JimCom123/Si4735_ESP32_Radio/SI4735-Radio-ESP32-Touchscreen-Arduino3/Sch_Brd/Photo Rev1.0/IMG_1637.jpg

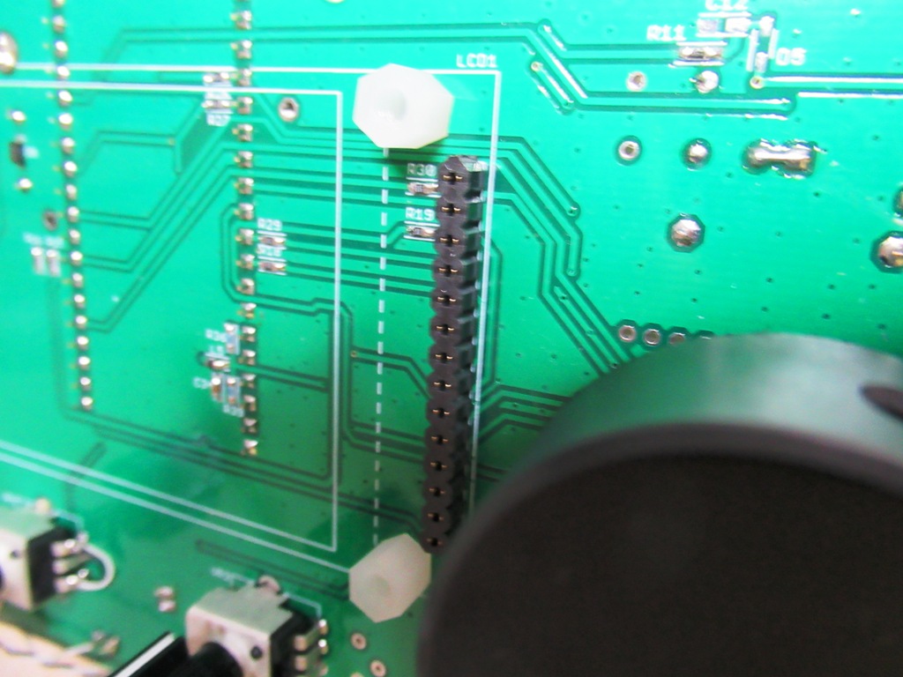
SI4735-Radio-ESP32-Touchscreen-Arduino3/Sch_Brd/Photo Rev1.0/IMG_1637.jpg
