JimCom123/Si4735_ESP32_Radio/README.md

# Si4735_ESP32_Radio
Based on SI4735-Radio-ESP32-2.8 inch TFT Touchscreen-Arduino and improved.
