JimCom123/Si4735_ESP32_Radio/SI4735-Radio-ESP32-Touchscreen-Arduino3/Sch_Brd/Si4735D60GU32_H6_BOM.xls

Value | Value | Qty | Part Num |  | Package | Parts
4.0uH | T37-6 37t | 1 | Amidon | 秋月電子 | T37 | L1 |  | T37-2 32t | T50-2 29t
BK1608HM601 | BK1608HM601 | 1 | Taiyo Yuden | Mouser | L0603 | L5
4.7uH | L0603B4R7MDWFT | 2 | KEMET | Mouser | L0603 | L6, L7
100nH | MLF2012DR10JT000 | 1 | TDK | Mouser | L0805 | L2 | MLF2012DR10JT000
220uH | AL0510-221K | 1 | Core Master | 秋月電子 | AL0510 | L3
2.2mH | AL0510-222K | 1 | Core Master | 秋月電子 | AL0510 | L4
2pF | 未実装 |  |  |  | C0402 | (C9)
10pF/50V | 未実装 |  |  |  | C0603 | (C23, C26, C32, C39, C40, C44, C45)
47pF/25V | C0603C470K3GACTU | 3 | KEMET | Mouser | C0603 | C6, C8, C10
220pF/50V | C0603C221K5GACAUTO |  | KEMET | Mouser | C0603 | (C12)
1000pF/50V | C0603C102K5GACAUTO | 1 | KEMET | Mouser | C0603 | C11
0.022uF/25V | GCJ188R71E223KA01D | 2 | Murata | Mouser | C0603 | C19, C29
0.1uF | GRM188R71H104KA93D | 12 | Murata | Mouser | C0603 | C3, C4, C7, C13, C14, C17, C22, C27, C28, C33, C34, C49
0.01uF | GRM188R71H103KA93D | 4 | Murata | Mouser | C0603 | C2, C46 +C4, +C7
0.47uF/25V | TMK107B7474KA | 3 | Taiyo Yuden | Mouser | C0603 | C1, C5, C15
1uF/25V | TMK107B7105KA-T | 5 | Taiyo Yuden | Mouser | C0603 | C21, C30, C35, C51, C53
2.2uF/16V | EMK107BJ225KA-T | 1 | Taiyo Yuden | Mouser | C0603 | C48
10uF/25V | GRM188R61E106KA73D | 3 | Murata | Mouser | C0603 | C16, C18, C25, (C31), (C38), (C43), (C52)
0.01uF/100V Film | 100MU103MA13216 | 1 | Rubycon | 秋月電子 | C1206 | C47
1uF/25V Film | 25MU105MA23216 | 1 | Rubycon | 秋月電子 | C1206 | C50
10uF/16V Film | 16MU106MC44532 | 2 | Rubycon | 秋月電子 | C4632 | C20, C24
0.022uF Film | MKS0C022200B00JSSD | 2 | WIMA | Mouser | C035-055X025 | C36, C37
0.0047uF Film | MKS02-4700/250/10 | 2 | WIMA | Mouser | C035-055X025 | C41, C42
47uF/25V | UKA1E470MDD | 1 | Nichicon | Mouser | CE-020X050 | C54 | 33uF/16V OS
NIL | 未実装 | 3 |  |  | R0603 | R28, R42, R43
0 | 0 | 1 | * | Mouser | R0603 | JP1
4.7 | 4.7 | 1 | * | Mouser | R0603 | R35
10 | 10 | 2 | * | Mouser | R0603 | R5, R23
22 | 22 | 1 | * | Mouser | R0603 | R22
51 | 51 | 10 | * | Mouser | R0603 | R2, R17, R18, R19, R26, R27, R29, R30, R44, R45
100 | 100 | 2 | * | Mouser | R0603 | R33, R34
390 | 390 | 2 | * | Mouser | R0603 | R37, R38
470 | 470 | 5 | * | Mouser | R0603 | R11, R12, R13, R40, R41
1.8k | 1.8k | 2 | * | Mouser | R0603 | R36, R39
4.7k | 4.7k | 4 | * | Mouser | R0603 | R14, R20, R24, R25
10k | 10k | 2 | * | Mouser | R0603 | R31, R32
15k | 15k | 2 | * | Mouser | R0603 | R15, R16
22k | 22k | 1 | * | Mouser | R0603 | R4
100k | 100k | 1 | * | Mouser | R0603 | R1
22 | 未実装 |  |  |  | R0402 | (R6, R7, R8)
560 | 未実装 |  |  |  | R0402 | (R9)
2k | 未実装 |  |  |  | R0402 | (R10)
4.7 1/2W | 4.7 1/2W | 1 | * | Mouser | R1206 | R21
FT37-77 12t | FT37-77 12t | 1 | * | Mouser | R1210 | R3
PTV09A-4025F-B103 | PTV09A-4025F-B103 | 1 | Bourns | Mouser |  | VR1
PTV09A-4025F-A103 | PTV09A-4025F-A103 | 1 | Bourns | Mouser |  | VR2
 | 未実装 | 1 | * |  | GF063P1 | TM1
NFM21PS106B0J3D | NFM21PS106B0J3D | 6 | Murata | Mouser | NFM21P | FIL1, FIL2, FIL3, FIL4, FIL5, FIL7
BNX016-01 | BNX016-01 | 1 | Murata | 秋月電子 | BNX0 | FIL6
SI4735-GU | SI4735-GU | 1 | SiLabs |  | SSOP24 | IC1
NJM2863F33 | NJM2863F33 | 1 | JRC | 秋月電子 | SOT23-5L | IC2
HT82V739SO | HT82V739SO | 1 | HOLTEK | 秋月電子 | SO08 | IC3
2SC3265Y | 2SC3265Y | 1 | Toshiba | 秋月電子 | SC59 | TR1
2SA1298Y | 2SA1298Y | 1 | Toshiba | 秋月電子 | SC59 | TR2
2SC2412KT146Q | 2SC2412KT146Q | 2 | Rohm | 秋月電子 | SC59 | TR3, TR4
2SK882GR | 2SK882GR (2SK241GR) | 1 | Toshiba |  | SC70 | FET1 | 2SK241GR
IRLML6402 | IRLML6402 | 1 | IR |  | SC70 | FET2
1N4148W | 1N4148W | 3 | Diodes | 秋月電子 | SOD2713X115N | (D5), D6, D7, D8
BAT43XV2 | BAT43XV2 | 4 | Fairchild | 秋月電子 | SODFL1608X70N | D1, D2, D3, D4
ECS-327TXO-33 | ECS-327TXO-33 | 1 | ECS | Mouser | XOSC | X1
M028C9341SD | M028C9341SD | 1 | HiLetgo | Amazon | M028C9341SD | LCD1
ESP32-DEVKITC v4 | ESP32-DevKitC-32D v4 | 1 | Espressif | 秋月電子 | ESP32-DEVKITC | U1
ADP3338AKCZ-3.3 | ADP3338AKCZ-3.3 | 1 | Analog | 秋月電子 |  | U1
PEC11R-4020F-S0024 | PEC11R-4020F-S0024 | 1 | Bourns | Mouser | PEC11R4220FS0024 | ENC1
SPPJ222200 | SPPJ222200 | 1 | ALPS | Mouser | SPPJ2 | SW1
UE200012 | UE200012 | 1 | ALPS | Mouser | SPPJ2 | SW1
S-037-TGG | S-037-TGG | 2 | COSMTEC | 秋月電子 | BU-SMA-V | CN1, CN2
B8B-PH-K-S | 未実装 | 1 | JST | Mouser | B8B-PH-K | (CN3)
B2B-XH2 | B2B-XH2 | 1 | JST | 秋月電子 | XH2 | CN4
MJ-179PH | MJ-179PH | 1 | マル信 | 秋月電子 | MJ179P | J1
MJ-354W-SG | MJ-354W-SG | 1 | マル信 | 秋月電子 | MJ-354W-SG | CN5
UDB-05LFPN | UDB-05LFPN | 1 | DB Products | 秋月電子 | 12mm | BZ1
スピーカー | SC400408-1 | 1 | DB Unlimited | Mouser | SPKR | SP1
KNOB | 11K5013-KMNB | 1 | Grayhill | Mouser | 33.78mm | ENC1
KNOB | 11K5014-KCNB | 2 | Grayhill | Mouser | 117.78mm | VR1, VR2
ピンソケット | FHU-1x42SG | 2 | Useconn | 秋月電子 |  | U1
ピンソケット | 2212S-04SG-36 | 1 | Neltron | 秋月電子 |  | LCD1 |  | LCDに実装されたピンヘッダーは取り外しロープロファイルタイプに交換
ピンソケット | 2212S-14SG-36 | 1 | Neltron | 秋月電子 |  | LCD1
ピンヘッダー | 2211S-14G-774 | 1 | Neltron | 秋月電子 |  | LCD1
ピンヘッダー | 2211S-40G-774 | 1 | Neltron | 秋月電子 |  | LCD1
ケース | SS-160B | 1 | タカチ | 共立電子
M3X12mmスペーサー | TPS-M3-12 | 6 | タカチ | 共立電子 |  | タッピング 基板用
M3x2.5mmスペーサー |  | 6 |  | 共立電子 |  | 中空 基板用
M3x6mmスペーサー | TPS632-6 | 4 |  | 秋月電子 |  | おねじめねじ LCD用
