JimCom123/Si4735_ESP32_Radio/(list of files, cad)

Other CAD files:
SI4735-Radio-ESP32-Touchscreen-Arduino3/Enclosure/SS-160B_20191216133921.dwg
