JimCom123/Si4735_ESP32_Radio/SI4735-Radio-ESP32-Touchscreen-Arduino3/Enclosure/Dim.pdf

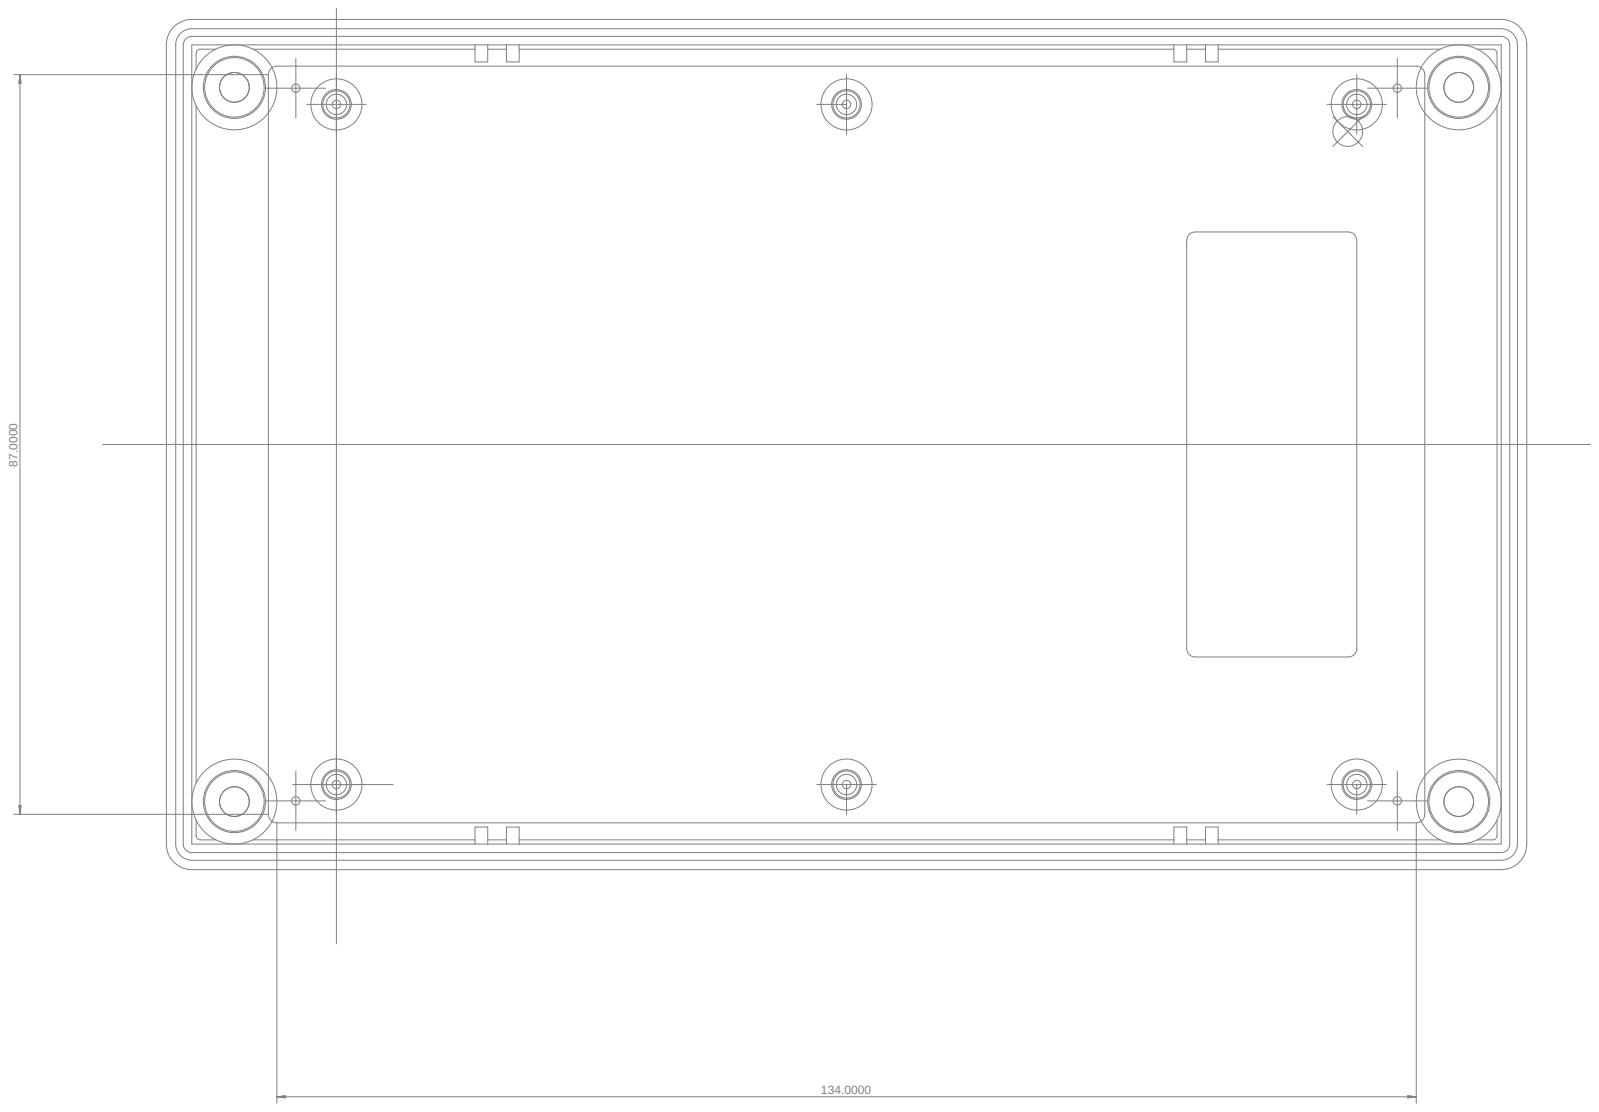
[picture p15: page 1]
