JimCom123/Si4735_ESP32_Radio/SI4735-Radio-ESP32-Touchscreen-Arduino3/Enclosure/DimS.pdf

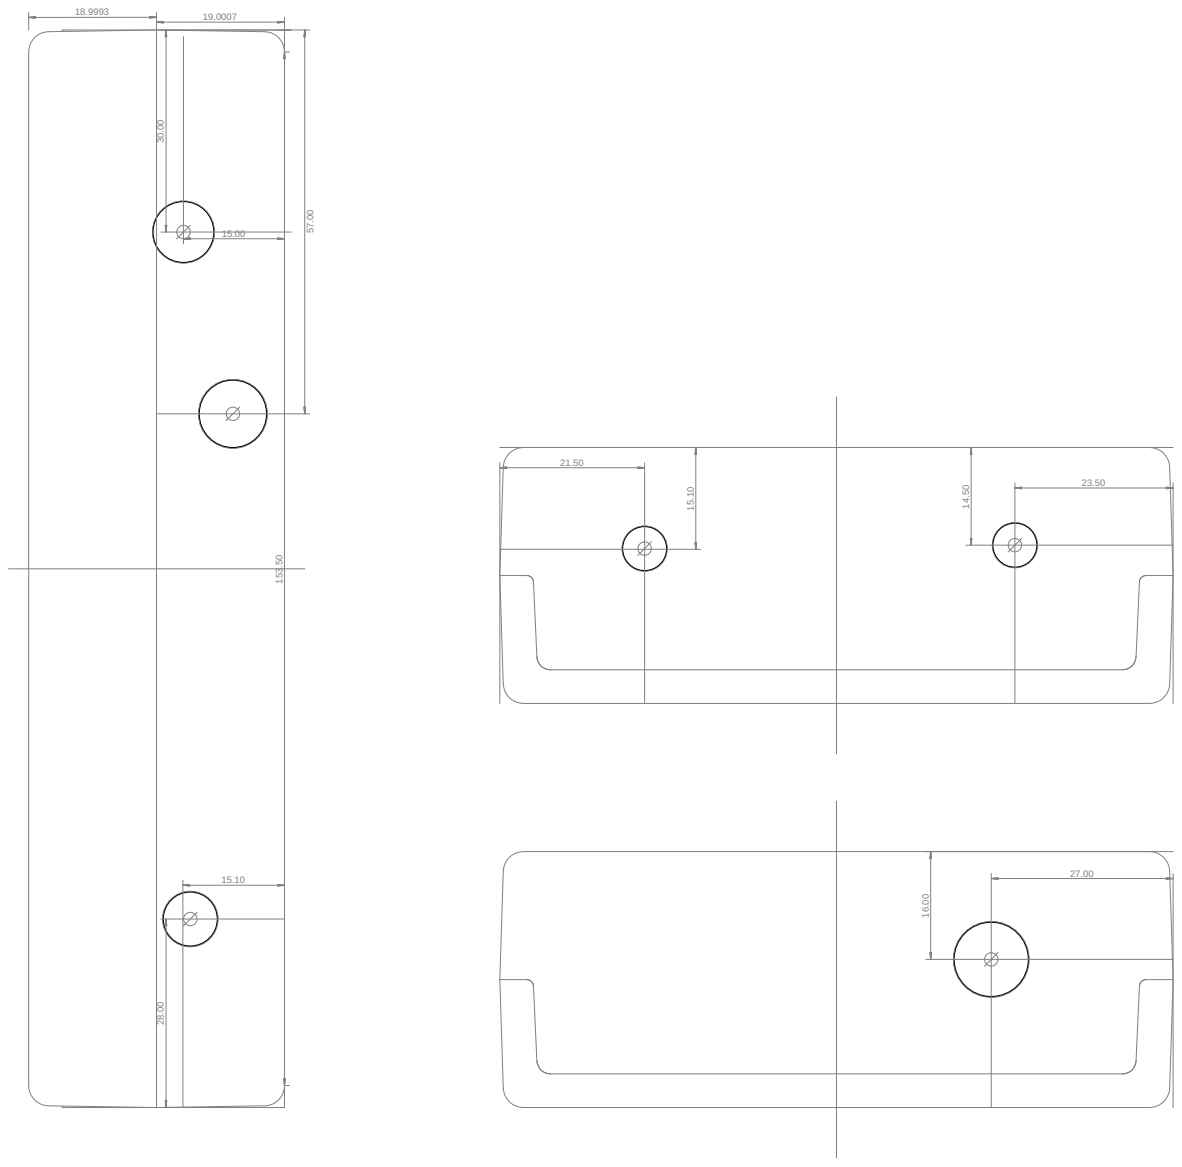
[picture p16: page 1]
