JimCom123/Si4735_ESP32_Radio/SI4735-Radio-ESP32-Touchscreen-Arduino3/Enclosure/Si4735D60GU32_H_6FNT.pdf

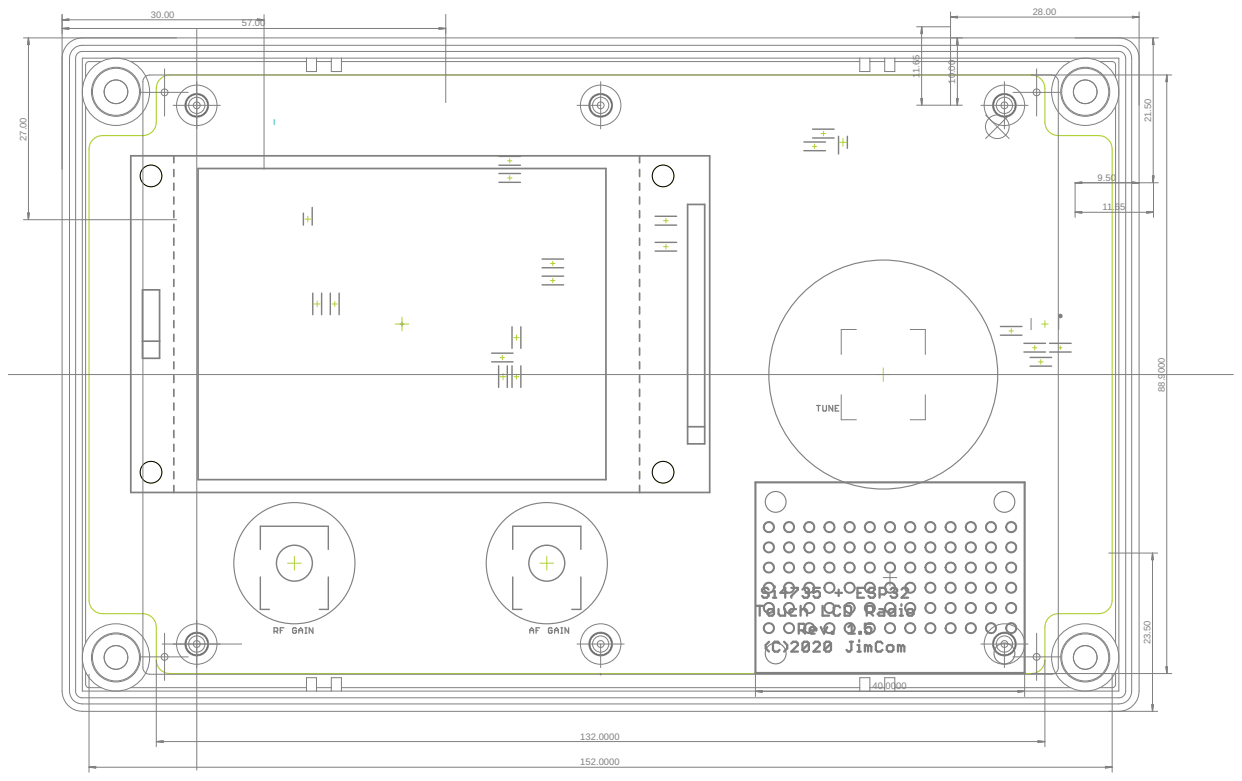
[picture p17: page 1]
