JimCom123/Si4735_ESP32_Radio/SI4735-Radio-ESP32-Touchscreen-Arduino3/Sch_Brd/Si4735D60GU32_H6_SCH.pdf

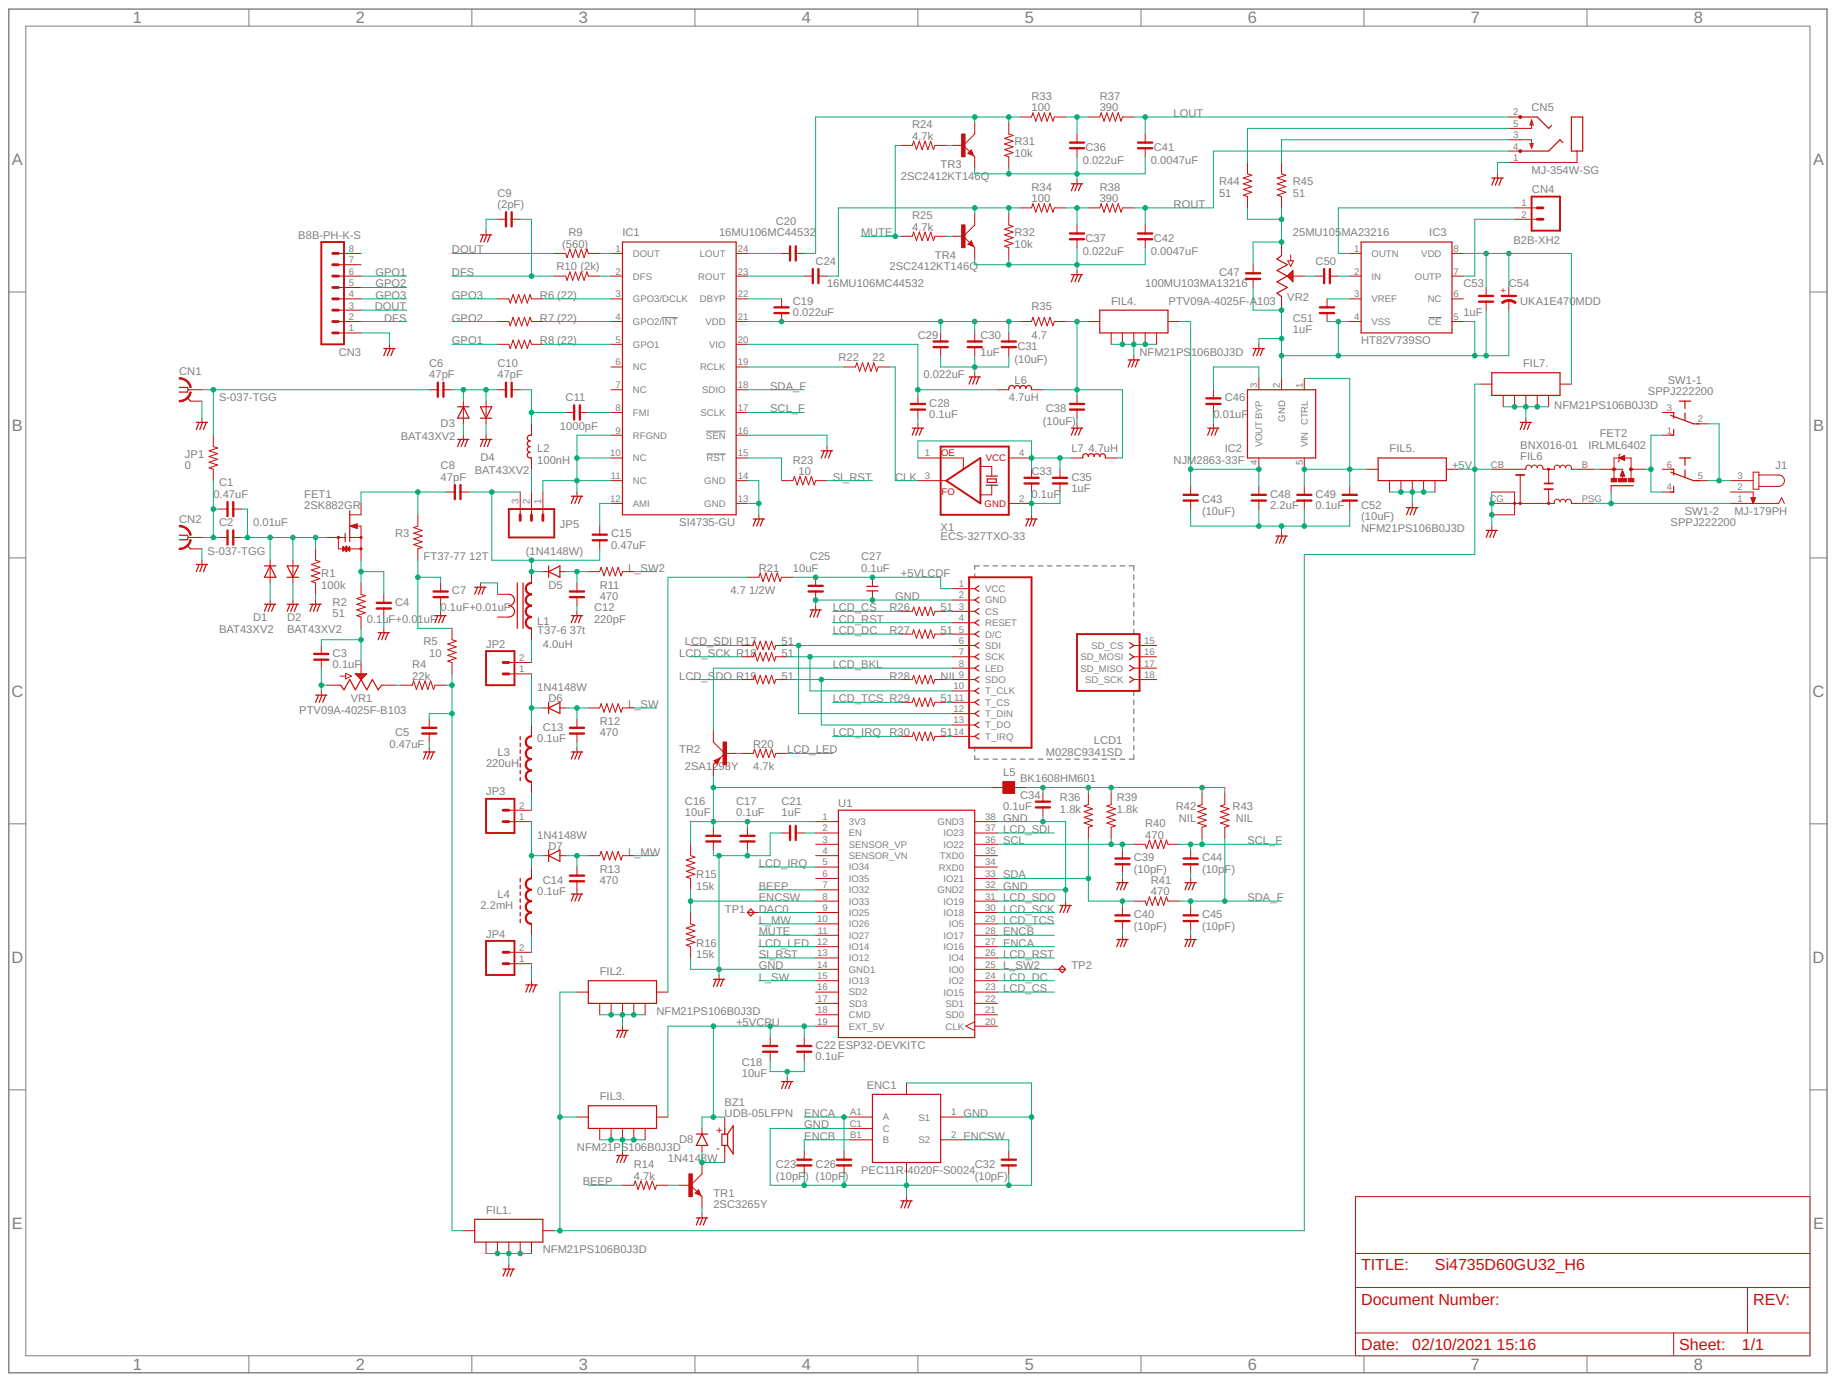
[picture p20: page 1]

Document Number: | REV:

Date: 02/10/2021 15:16 | Sheet: 1/1
