JimCom123/Si4735_ESP32_Radio/SI4735-Radio-ESP32-Touchscreen-Arduino3/Sch_Brd/Si4735D60GU32_H6_TOP.pdf

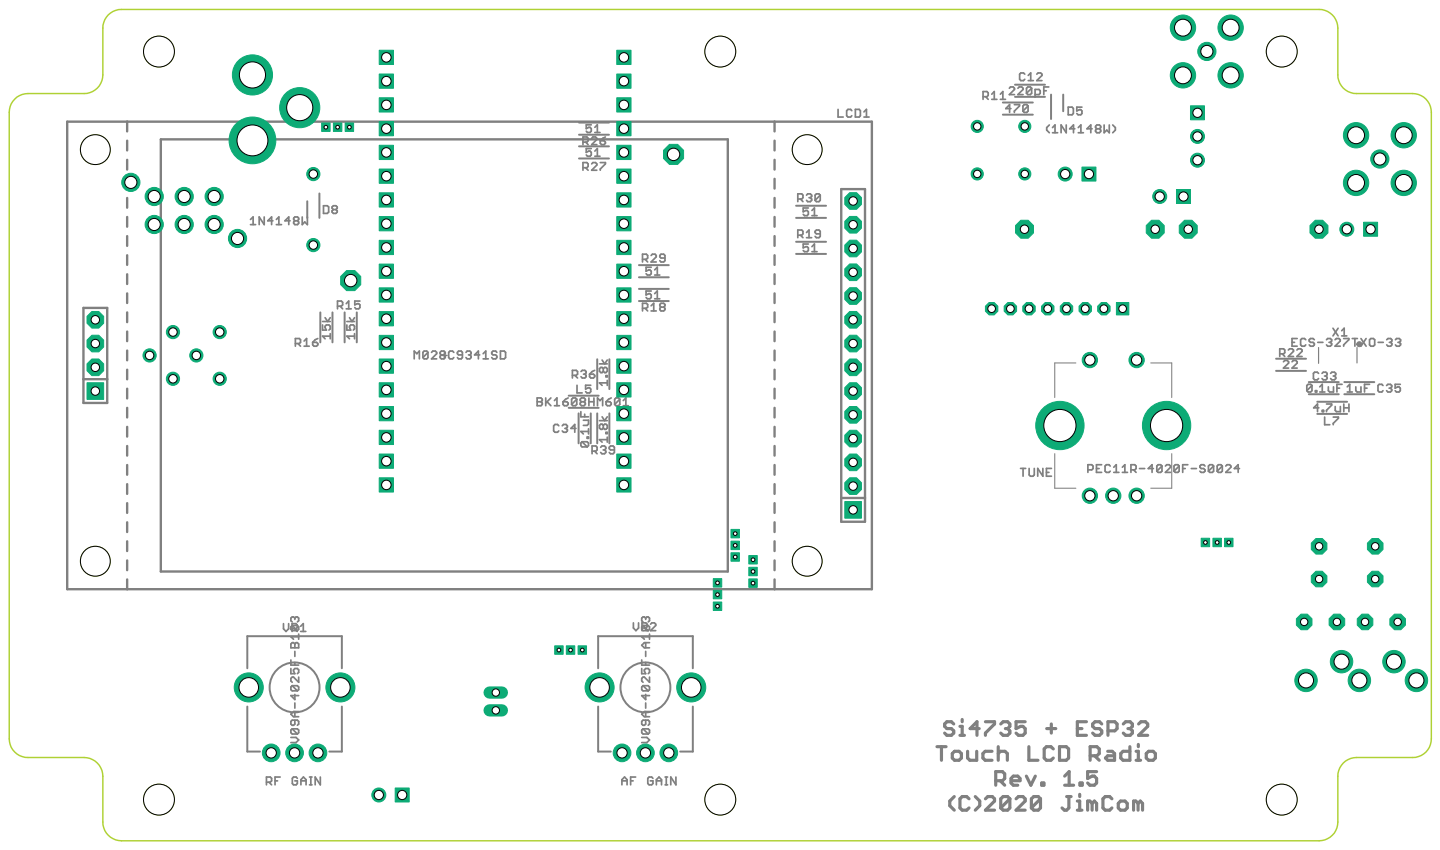
[picture p21: page 1]
