JimCom123/Si4735_ESP32_Radio/SI4735-Radio-ESP32-Touchscreen-Arduino3/SI4735_2.8_TFT_V3.4/patch_full.h

/*
 * This file was adapted to C/C++ from  the original file (amrx_6_0_1_ssbrx_patch_full_0x9D29.csg) made available by 
 * Mr Vadim Afonkin on his Dropbox repository (https://www.dropbox.com/sh/xzofrl8rfaaqh59/AAA5au2_CVdi50NBtt0IivyIa?dl=0).  
 * 
 * I would like to thank [Mr Vadim Afonkin](https://youtu.be/fgjPGnTAVgM) for making available the SSBRX patches for 
 * SI4735-D60 on his [Dropbox repository](https://www.dropbox.com/sh/xzofrl8rfaaqh59/AAA5au2_CVdi50NBtt0IivyIa?dl=0). 
 * 
 * It is important to know that the patch content of the original file is in const hexadecimal representation. 
 * Actally, the original file is in ASCII format.  
 * If you are not using C/C++ or if you want to load the files directly to the SI4735, you must convert 
 * the values to numeric values of the hexadecimal constants. For example: 0x15 = 21 (00010101); 
 * 0x16 = 22 (00010110); 0x01 = 1 (00000001); 0xFF = 255 (11111111); 
 *  
 */
// SSB patch for whole SSBRX full download
const PROGMEM uint8_t ssb_patch_content[] =
    {   0x15, 0x00, 0x0F, 0xE0, 0xF2, 0x73, 0x76, 0x2F,
        0x16, 0x6F, 0x26, 0x1E, 0x00, 0x4B, 0x2C, 0x58,
        0x16, 0xA3, 0x74, 0x0F, 0xE0, 0x4C, 0x36, 0xE4,
        0x16, 0x0A, 0xE0, 0xF8, 0xCD, 0xF3, 0x87, 0xDA,
        0x16, 0x2E, 0xA1, 0xDF, 0x6E, 0xEB, 0x35, 0x9C,
        0x16, 0x9F, 0x1A, 0x09, 0xEE, 0xB9, 0xB5, 0x45,
        0x16, 0xA3, 0x5C, 0x0F, 0xA2, 0xC1, 0x3F, 0xAE,
        0x16, 0x85, 0x52, 0x44, 0x77, 0x31, 0xEA, 0x84,
        0x16, 0x4F, 0xFD, 0x0C, 0x54, 0x7F, 0x45, 0xCF,
        0x16, 0xF9, 0x27, 0x02, 0x4E, 0x09, 0xA2, 0x68,
        0x16, 0x7F, 0x9C, 0xF8, 0xCF, 0x33, 0x39, 0x2D,
        0x16, 0x56, 0x8E, 0xC2, 0x34, 0xF8, 0x73, 0x76,
        0x16, 0xB9, 0x5E, 0x5C, 0x4A, 0xFD, 0x61, 0x00,
        0x16, 0x66, 0x51, 0x85, 0xD1, 0x55, 0x30, 0x34,
        0x16, 0x50, 0x79, 0x47, 0x24, 0xC0, 0x19, 0x66,
        0x16, 0xD4, 0x58, 0x80, 0x5B, 0xCF, 0x86, 0x71,
        0x16, 0x6D, 0x78, 0x26, 0xA2, 0x89, 0x47, 0x6F,
        0x16, 0x1B, 0xDE, 0x0F, 0x23, 0xB2, 0x5B, 0x65,
        0x16, 0x0D, 0x66, 0x82, 0x93, 0x12, 0xC6, 0x2E,
        0x16, 0x58, 0x45, 0xF4, 0xA3, 0x84, 0x20, 0x65,
        0x16, 0x07, 0xDB, 0x22, 0x30, 0x36, 0x60, 0x9B,
        0x16, 0x92, 0x68, 0xC4, 0x77, 0xF1, 0x7C, 0x98,
        0x16, 0x74, 0xA3, 0xD5, 0xD6, 0xE7, 0xFE, 0xE2,
        0x16, 0x64, 0x94, 0x18, 0x4E, 0x7A, 0xBF, 0x4D,
        0x16, 0xB4, 0x71, 0xAB, 0x0B, 0x2D, 0x9A, 0x35,
        0x16, 0x35, 0x9F, 0xFE, 0x07, 0xED, 0x0E, 0xDC,
        0x16, 0xAE, 0xCD, 0xC5, 0x2D, 0x53, 0x8E, 0xD6,
        0x16, 0x16, 0xC4, 0x10, 0x10, 0x3D, 0x09, 0x40,
        0x16, 0xC0, 0x9A, 0x76, 0xE8, 0x0B, 0x12, 0x3F,
        0x16, 0xB8, 0x49, 0xE1, 0x4F, 0xB9, 0x6C, 0x57,
        0x16, 0x03, 0x31, 0x22, 0xA5, 0x41, 0xC8, 0xC6,
        0x16, 0x92, 0x48, 0x64, 0x90, 0x3C, 0x7A, 0xA3,
        0x16, 0x41, 0x2E, 0x2C, 0x48, 0x4C, 0xDA, 0xD9,
        0x16, 0xF3, 0xF8, 0x11, 0xA2, 0x33, 0x54, 0x2F,
        0x16, 0x37, 0xAC, 0x1B, 0xA8, 0x30, 0x03, 0xCB,
        0x16, 0x6F, 0x2F, 0xC6, 0xE8, 0x37, 0x1D, 0xB6,
        0x16, 0x74, 0xAD, 0x5A, 0x07, 0x39, 0x35, 0xF3,
        0x16, 0x55, 0x6F, 0xDB, 0xC3, 0x24, 0xFE, 0x97,
        0x16, 0x89, 0xF9, 0x2A, 0x18, 0x9C, 0xEE, 0x7B,
        0x16, 0xEF, 0x7E, 0x53, 0x5A, 0xEA, 0xB2, 0x66,
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
