JimCom123/Si4735_ESP32_Radio/SI4735-Radio-ESP32-Touchscreen-Arduino3/SI4735_2.8_TFT_V3.4/patch_init.h

/*
 * This file was adapted to C/C++ from  the original file (amrx_6_0_1_ssbrx_patch_init_0xA902.csg) made available by 
 * Mr Vadim Afonkin on his Dropbox repository (https://www.dropbox.com/sh/xzofrl8rfaaqh59/AAA5au2_CVdi50NBtt0IivyIa?dl=0).  
 * 
 * I would like to thank [Mr Vadim Afonkin](https://youtu.be/fgjPGnTAVgM) for making available the SSBRX patches for 
 * SI4735-D60 on his [Dropbox repository](https://www.dropbox.com/sh/xzofrl8rfaaqh59/AAA5au2_CVdi50NBtt0IivyIa?dl=0).  
 * 
 * It is important to know that the patch content of the original file is in const hexadecimal representation. 
 * Actally, the original file is in ASCII format.  
 * If you are not using C/C++ or if you want to load the files directly to the SI4735, you must convert 
 * the values to numeric values of the hexadecimal constants. For example: 0x15 = 21 (00010101); 
 * 0x16 = 22 (00010110); 0x01 = 1 (00000001); 0xFF = 255 (11111111); 
 * 
 */

// SSB patch for whole SSBRX initialization string
// You can remove PROGMEM if you have enough RAM memory 
// const PROGMEM  uint8_t ssb_patch_content[] =
const PROGMEM  uint8_t ssb_patch_content[] =   // Nice if Arduino DUE or ESP32
		{0x15, 0x00, 0x03, 0x74, 0x0B, 0xD4, 0x84, 0x60,
		 0x16, 0x6F, 0xAE, 0x6C, 0xF9, 0xBB, 0x84, 0xA2,
		 0x16, 0x65, 0xB1, 0x4B, 0xF6, 0x72, 0x01, 0x1A,
		 0x16, 0x21, 0xE8, 0x5A, 0xD8, 0xD6, 0x04, 0x73,
		 0x16, 0x5E, 0x2C, 0x22, 0x6E, 0xC4, 0xE9, 0xB5,
		 0x16, 0x8B, 0x81, 0x9A, 0x1E, 0xE4, 0x87, 0xC9,
		 0x16, 0x9E, 0x7B, 0x17, 0x52, 0x6D, 0xAD, 0xE3,
		 0x16, 0xE5, 0x8B, 0x04, 0xA7, 0x2E, 0x99, 0x6A,
		 0x16, 0x32, 0xAA, 0x99, 0x97, 0xCC, 0xA6, 0x5B,
		 0x16, 0x15, 0x79, 0x56, 0x48, 0x01, 0x63, 0xB1,
		 0x16, 0xDF, 0x54, 0x27, 0x06, 0x57, 0x06, 0x53,
		 0x16, 0x8C, 0xA6, 0x27, 0xAA, 0x66, 0x89, 0x03,
		 0x16, 0x18, 0x51, 0x7E, 0xFB, 0x67, 0xD3, 0xCE,
		 0x16, 0xDD, 0x3F, 0xFD, 0x3D, 0x1F, 0x47, 0x84,
		 0x16, 0x01, 0xF3, 0x85, 0x6E, 0xF8, 0x3B, 0x79,
		 0x16, 0x2B, 0x0C, 0x90, 0x4B, 0x67, 0x46, 0x7D,
		 0x16, 0x54, 0x88, 0xFD, 0xD6, 0x12, 0xE5, 0xE7,
		 0x16, 0x48, 0xF2, 0x0E, 0xDB, 0x99, 0x4D, 0x71,
		 0x16, 0xA5, 0x40, 0x68, 0xD9, 0xC9, 0x59, 0x39,
		 0x16, 0xE4, 0x75, 0x20, 0x1C, 0xE9, 0xB1, 0xF5,
		 0x16, 0x01, 0x3C, 0x19, 0xBB, 0x60, 0xF7, 0xFA,
		 0x16, 0x6B, 0x1E, 0x68, 0x9F, 0x19, 0xB6, 0xED,
		 0x16, 0x14, 0x0F, 0x56, 0xBC, 0xC1, 0x34, 0xCB,
		 0x16, 0x00, 0x9D, 0x43, 0xD4, 0x0F, 0xF3, 0x62,
		 0x16, 0x9C, 0x9D, 0xF7, 0x8B, 0x9D, 0x53, 0x3A,
		 0x16, 0x8D, 0x2F, 0x3D, 0xDE, 0x3D, 0x38, 0x31,
		 0x16, 0x03, 0x9B, 0xC7, 0xC1, 0x59, 0xE9, 0xD1,
		 0x16, 0x75, 0x88, 0x8D, 0x36, 0x58, 0x86, 0x70,
		 0x16, 0x4E, 0x5B, 0x9E, 0xD0, 0xDB, 0xCB, 0xF7,
		 0x16, 0xEA, 0x1F, 0xDB, 0xA5, 0x3B, 0xB3, 0xBD,
		 0x16, 0x6B, 0xBC, 0xF3, 0x70, 0x65, 0xD5, 0x17,
		 0x16, 0x0F, 0x64, 0x15, 0x24, 0x20, 0xD5, 0xB8,
		 0x16, 0x7B, 0x0D, 0x27, 0x29, 0x85, 0x88, 0x1F,
		 0x16, 0x58, 0x22, 0x57, 0x4F, 0x09, 0xC0, 0x4D,
		 0x16, 0xD6, 0xE4, 0xC6, 0xB5, 0x3A, 0x37, 0x33,
		 0x16, 0x27, 0xBB, 0x6A, 0x14, 0x69, 0x03, 0x1B,
		 0x16, 0xED, 0xA8, 0xC3, 0x43, 0xE8, 0xEA, 0xDE,
		 0x16, 0x41, 0x06, 0x25, 0xC5, 0xC8, 0x3C, 0xBF,
		 0x16, 0x32, 0xB2, 0xA7, 0xDD, 0x22, 0xC2, 0xE9,
		 0x16, 0xCA, 0x84, 0xF2, 0xC0, 0x26, 0x7C, 0x78,
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
